Leczez/TSIU51/Dokument/fyra_I_rad.jpg

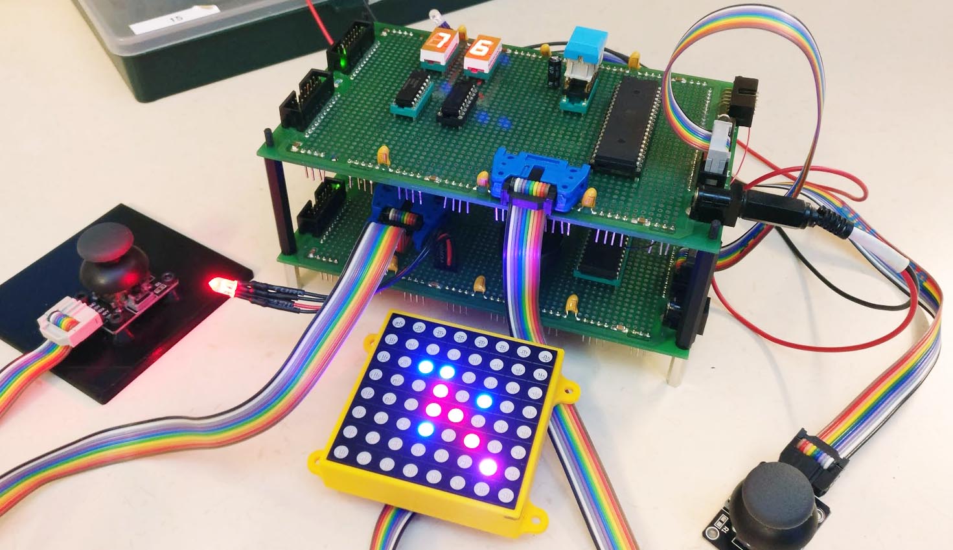
Dokument/fyra_I_rad.jpg
