Leczez/TSIU51/Dokument/IMG_20200312_121848.jpg

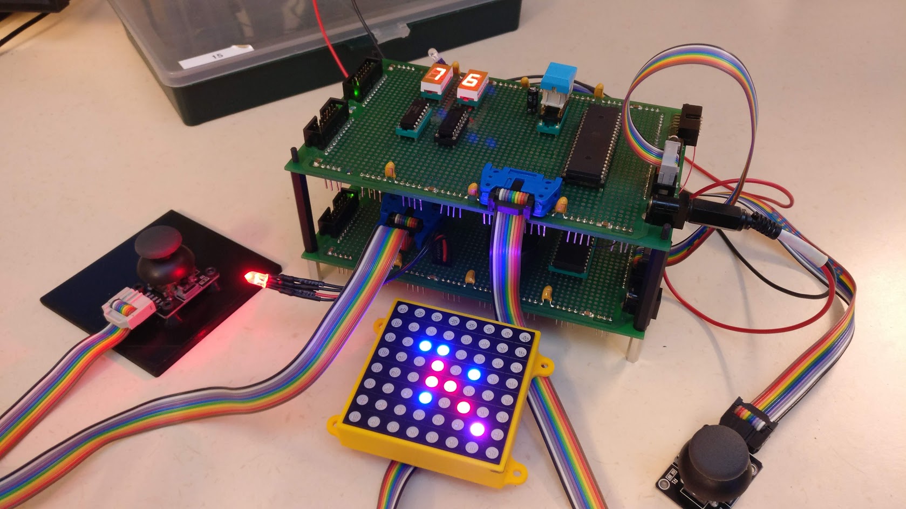
Dokument/IMG_20200312_121848.jpg
