Leczez/TSIU51/Dokument/Dataprotokoll.odt

Förslag på dataprotokoll mellan spelprocessorn och grafikprocessorn

Data skickas med UART, 8 databitar och 1 stopbit, 9600 baudrate, ingen paritetsbit

Tre byte skickas i ett meddelande.

Första byten är alltid 0xFF. Detta används för att veta vad som är början på medelandet.

Andra byten beskriver vad som ska göras. Detta är ett tal som är t.ex är:

- 0 om spelare1 placerar markör här
- 1 om spelare2 placerar markör här
- 2 om spelare1 väljer denna platsen (alltså placerar här)
- 3 om spelare2 väljer denna platsen (alltså placerar här)
- 4 för att skicka poäng t rensa skärmen

Vi kan också lägga till andra komandon här, t.ex. för att rensa displayerna för en ny omgång eller visa en speciell bild på displayen eller liknande.

Tredje byten är index på X-Led. Detta är ett tal mellan 0 och 7. Om kommandot är 4 så är detta player 1 poäng.

Fjärde byten är index på Y-Led. Detta är ett tal mellan 0 och 7. Om kommandot är 4 så är detta player 2 poäng.

Exempel på meddelande:

$FF $00 $02 $02. Vilket i människospråk blir ”Spelare 1 väljer denna platsen (2,2).
