Leczez/TSIU51/Dokument/blockDiagram.png

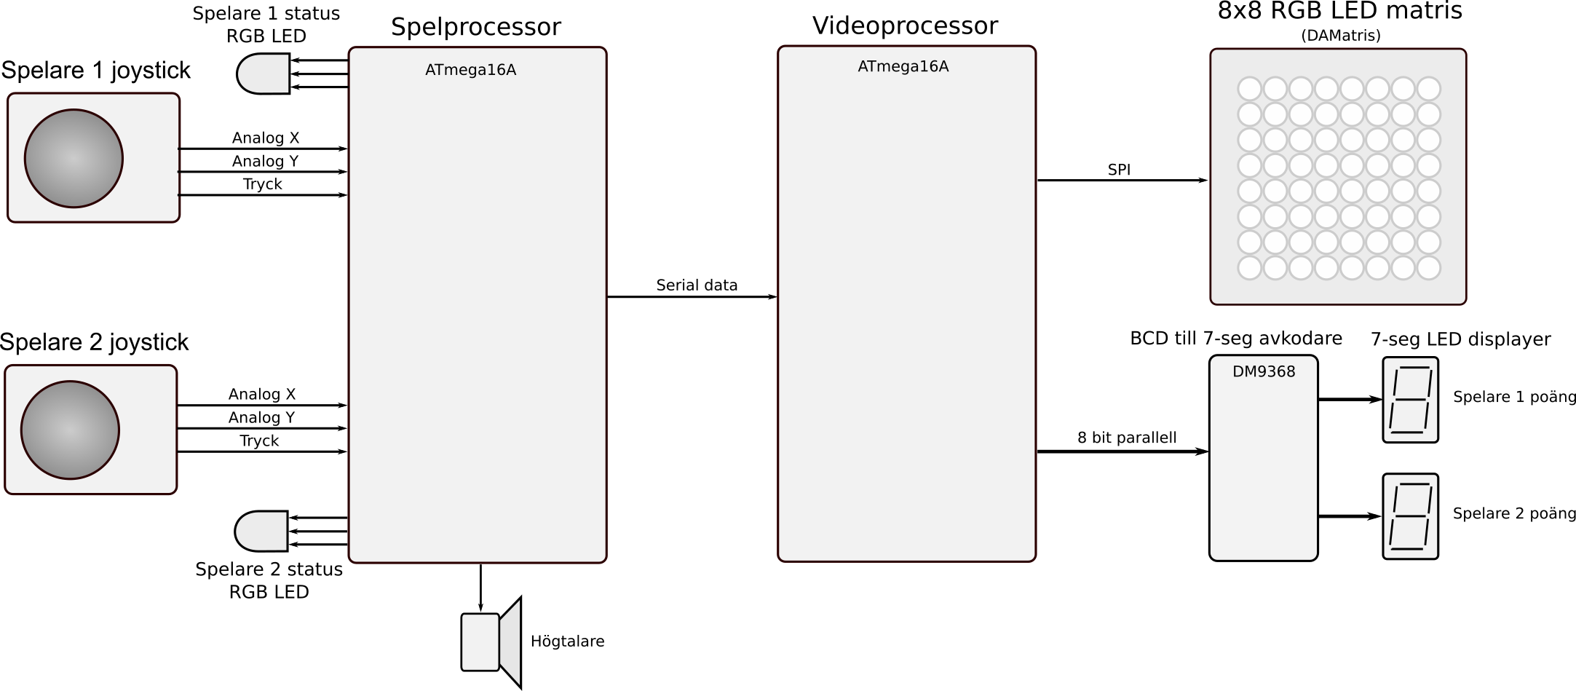
Dokument/blockDiagram.png
