Leczez/TSIU51/Dokument/joystick.png

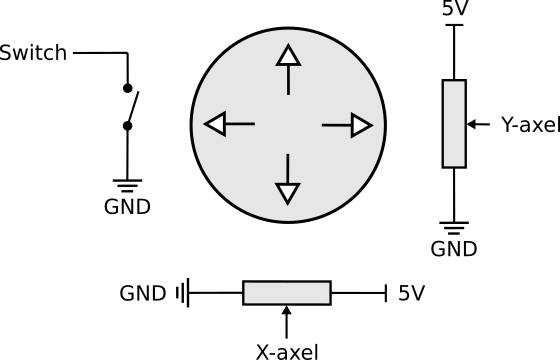
Dokument/joystick.png
