Leczez/TSIU51/Dokument/kopplingsschema.png

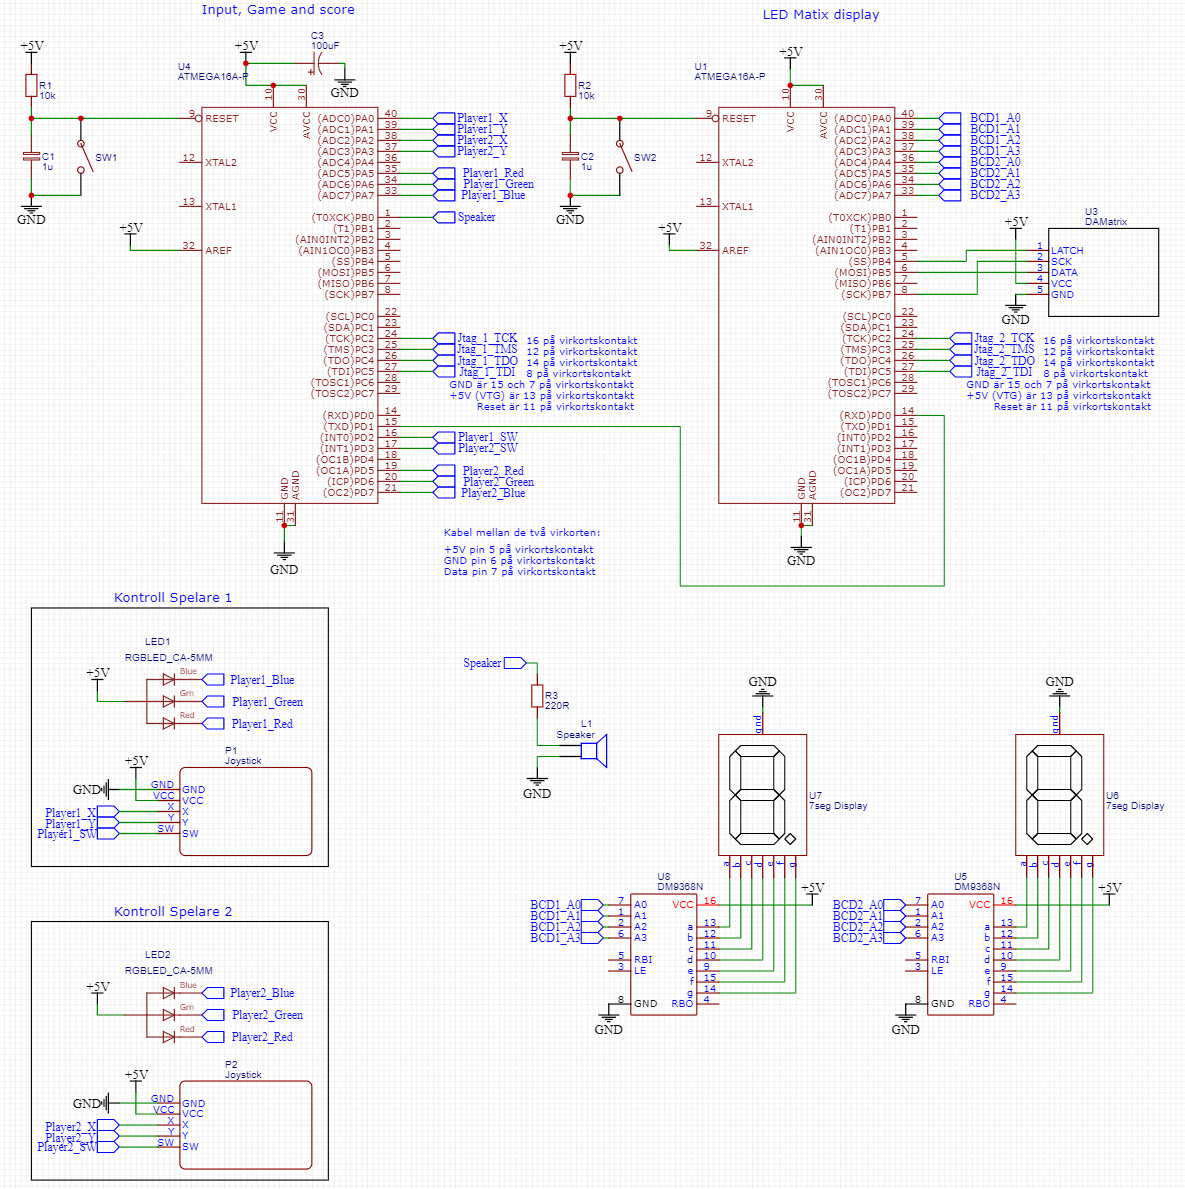
Dokument/kopplingsschema.png
