Leczez/TSIU51/Dokument/TSIU51projekt_Blockschema gammal.png

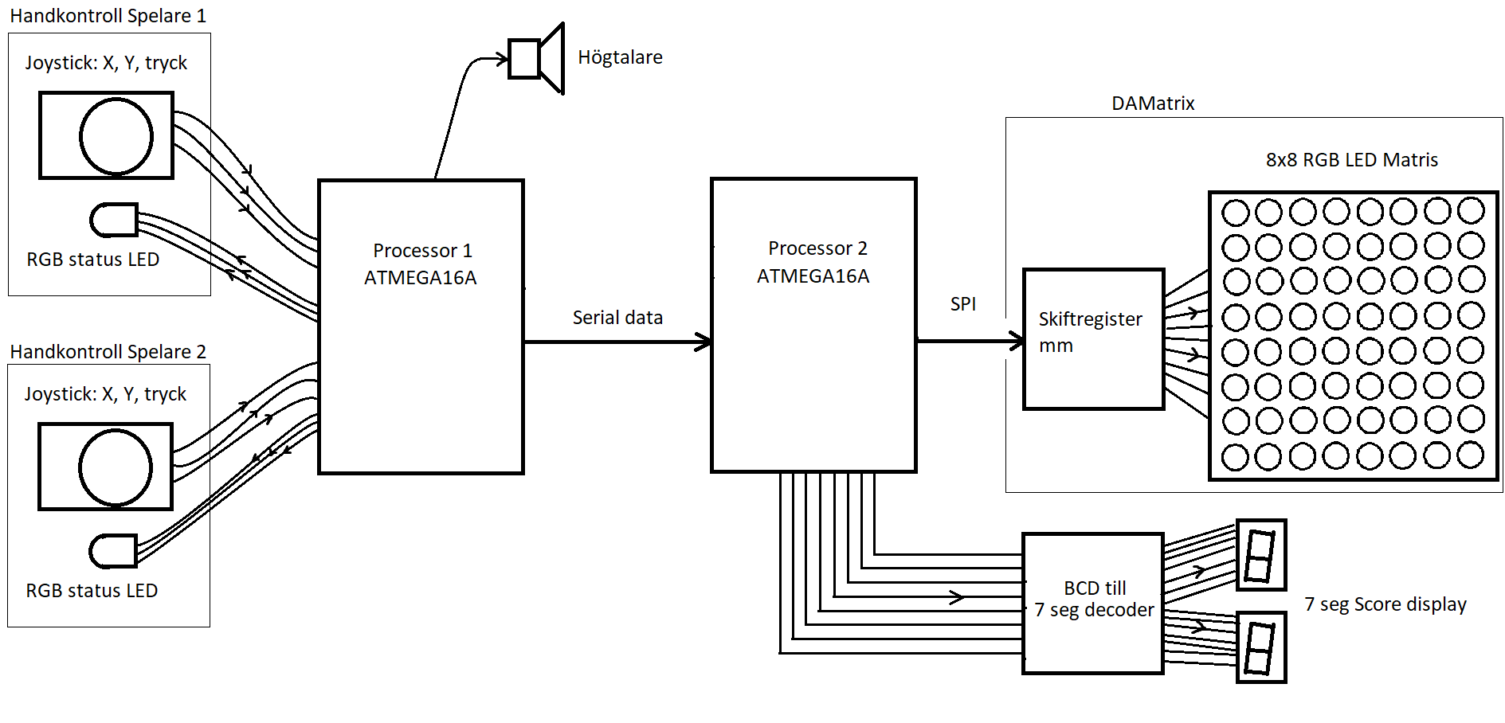
Dokument/TSIU51projekt_Blockschema gammal.png
