Leczez/TSIU51/Dokument/Untitled Diagram.png

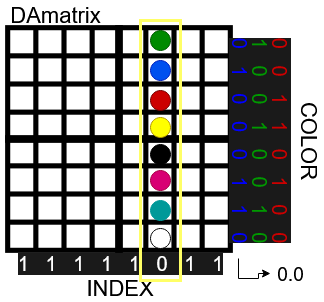
Dokument/Untitled Diagram.png
