Leczez/TSIU51/(commit log)

2020-02-04 Gjort början på en Joystick Driver
2020-02-23 Fixade lite UART-saker och lade till datablad mm
    [Spelprocessor.asm]
2020-02-28 initial UART commit
2020-02-28 UART included
2020-02-28 UART update
2020-02-28 uart implement
2020-03-02 UART interrupt
2020-03-02 tar nu in en byte i interrupt
2020-03-05 fixade en mindre bugg i spelprocessorn -Linus C
    [Joystick_driver.asm, Spelprocessor.asm]
2020-03-10 Började på Power Point för test-pressentation
2020-03-10 Uppdaterad powerpoint
